StevenWin818/ThreeDigitBcdAdder/(list of files, drawings)

Other design files:
74HC-series-adder-project.ms14
