StevenWin818/ThreeDigitBcdAdder/(commit log)

2025-07-27 update project
    [74HC-series-adder-project.ms14]
2025-07-27 修正电路实现描述中的格式问题，并更新物料清单
